paulocode/picostation_pcb/(threads)

Thread 4 (2023-02-09):

D1 SOD-123 1N5819 solder direction

tai1976, 2023-02-09:
Ordered some boards from OSH Park. Does the D1 cathode direct towards the 7805 or the Pico?
All the other components are pretty straight forward. I soldered the cathode towards the Pico but now I'm thinking the opposite.
Thank you for all your work.

ryanm101, 2023-02-15:
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

Neg / bar side towards pico.. Current flows FROM regulator TO pico

Slypty, 2023-03-30:
Thank you

Thread 8 (2023-02-20):

Adjust H1 position

BenoitCaron, 2023-02-20:
When placing the board inside of a 5502 or 1002 PS1, the fit is too tight. I think H1 should be positioned very slightly higher. H1, H2 and H3 could also benefit from getting a little larger, to accommodate for positioning issues.
