paulocode/picostation_pcb/(commit log)

2023-02-15 Tidied up Sch by using labels
    [picostation_pcb.kicad_pcb, picostation_pcb.kicad_sch]
2023-02-15 Updated References
    [picostation_pcb.kicad_pcb, picostation_pcb.kicad_sch]
